TomNisbet/Simple8085/docs/_docs/images/logic-analyzers.png

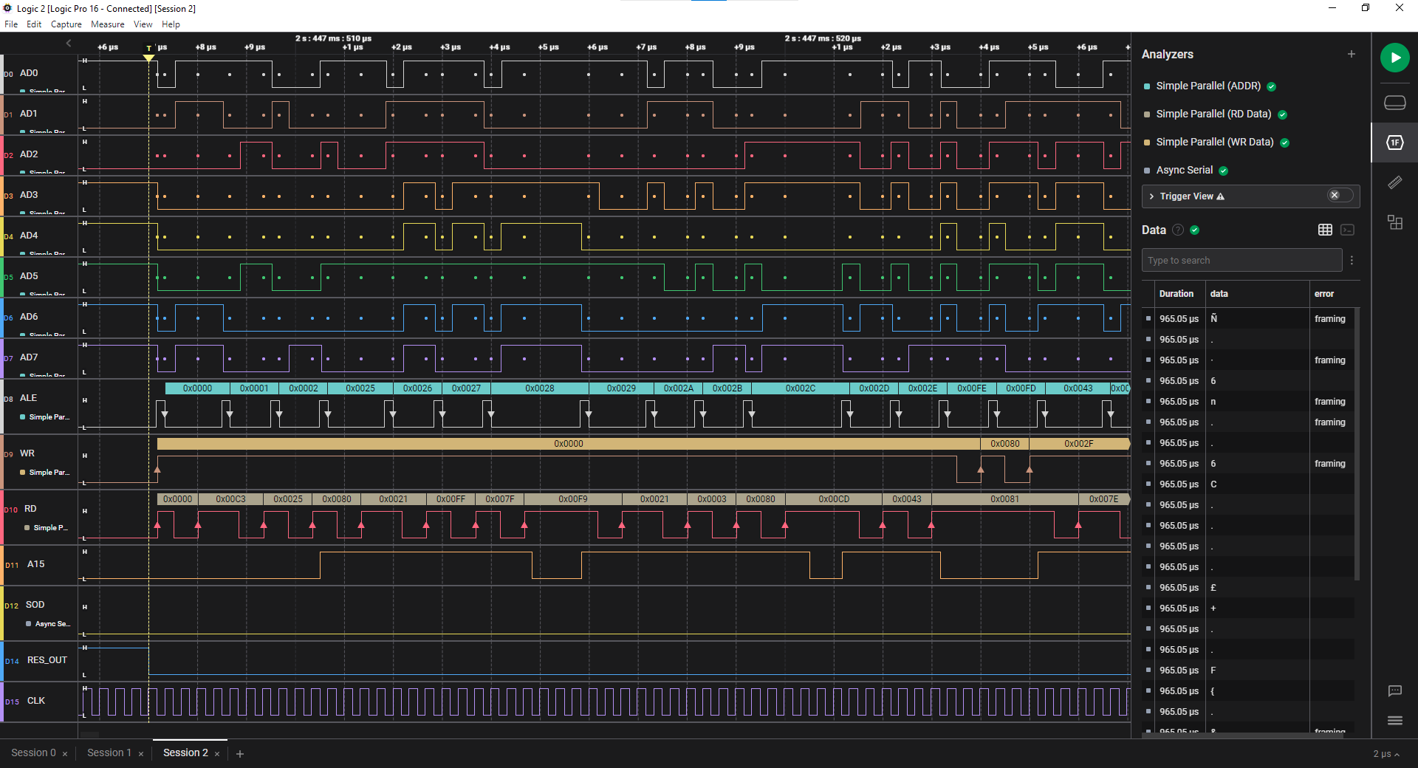
docs/_docs/images/logic-analyzers.png
