TomNisbet/Simple8085/docs/_docs/images/logic-capture.png

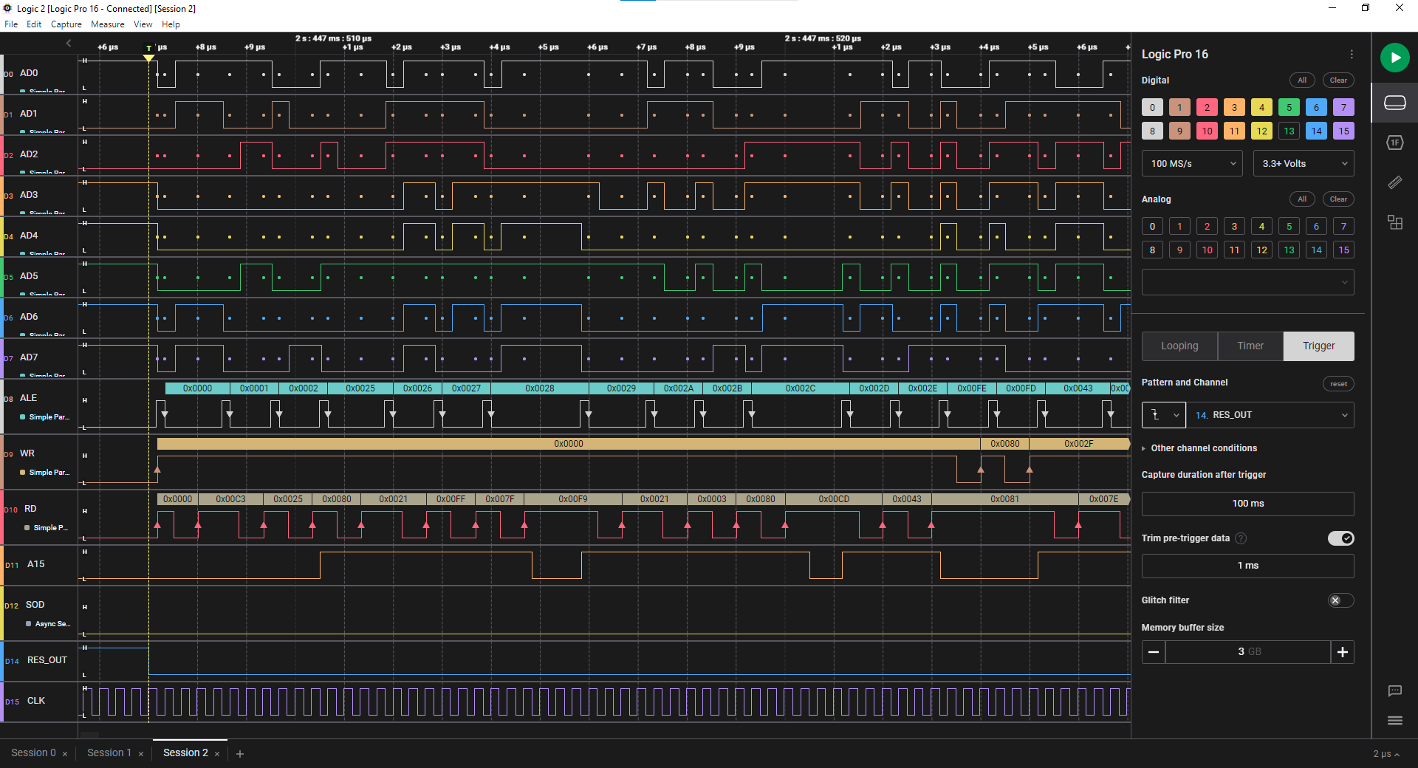
docs/_docs/images/logic-capture.png
