TomNisbet/Simple8085/docs/_docs/images/saleae-logic.jpg

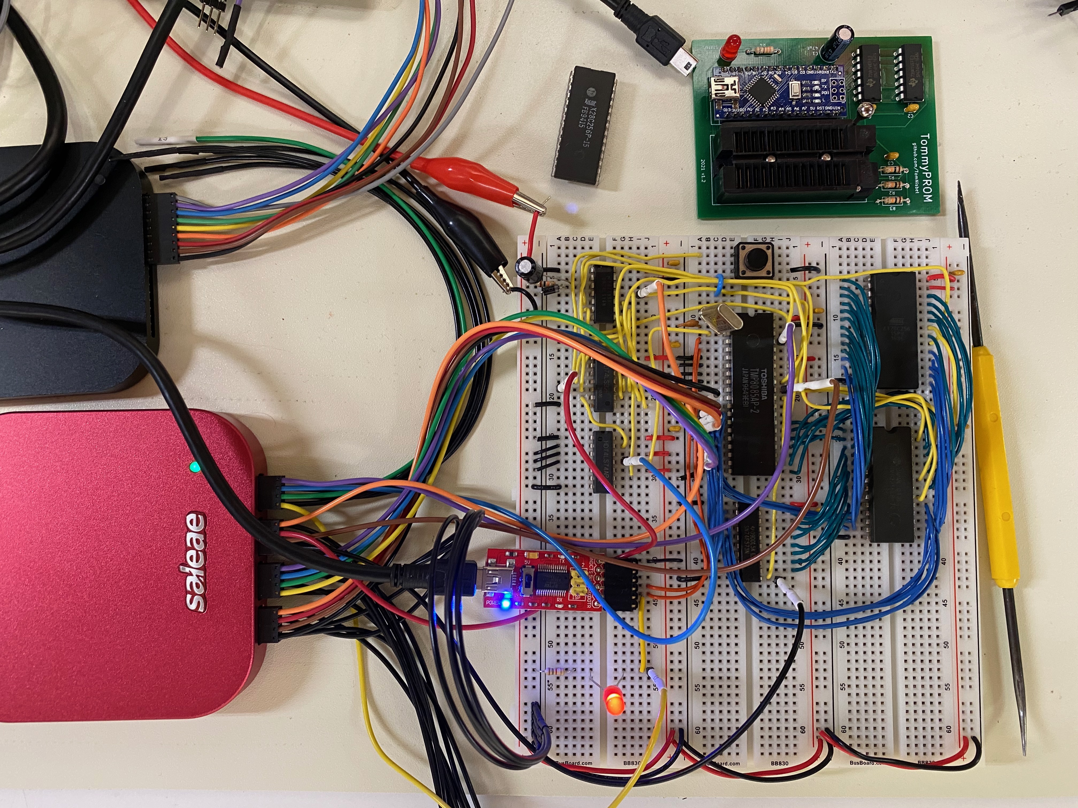
docs/_docs/images/saleae-logic.jpg
