TomNisbet/Simple8085/docs/_docs/images/simple8085-500.jpg

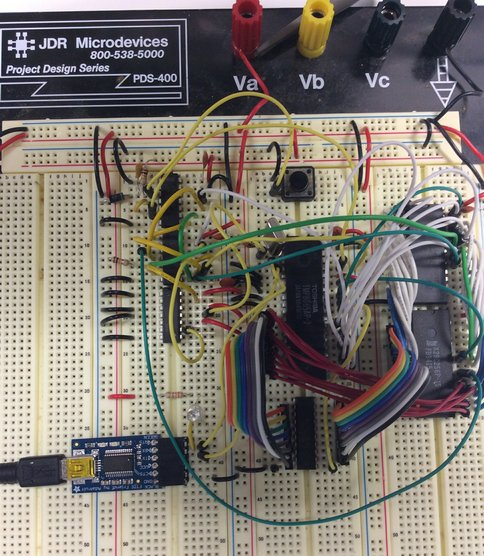
docs/_docs/images/simple8085-500.jpg
