TomNisbet/Simple8085/docs/_docs/images/simple8085-sch.png

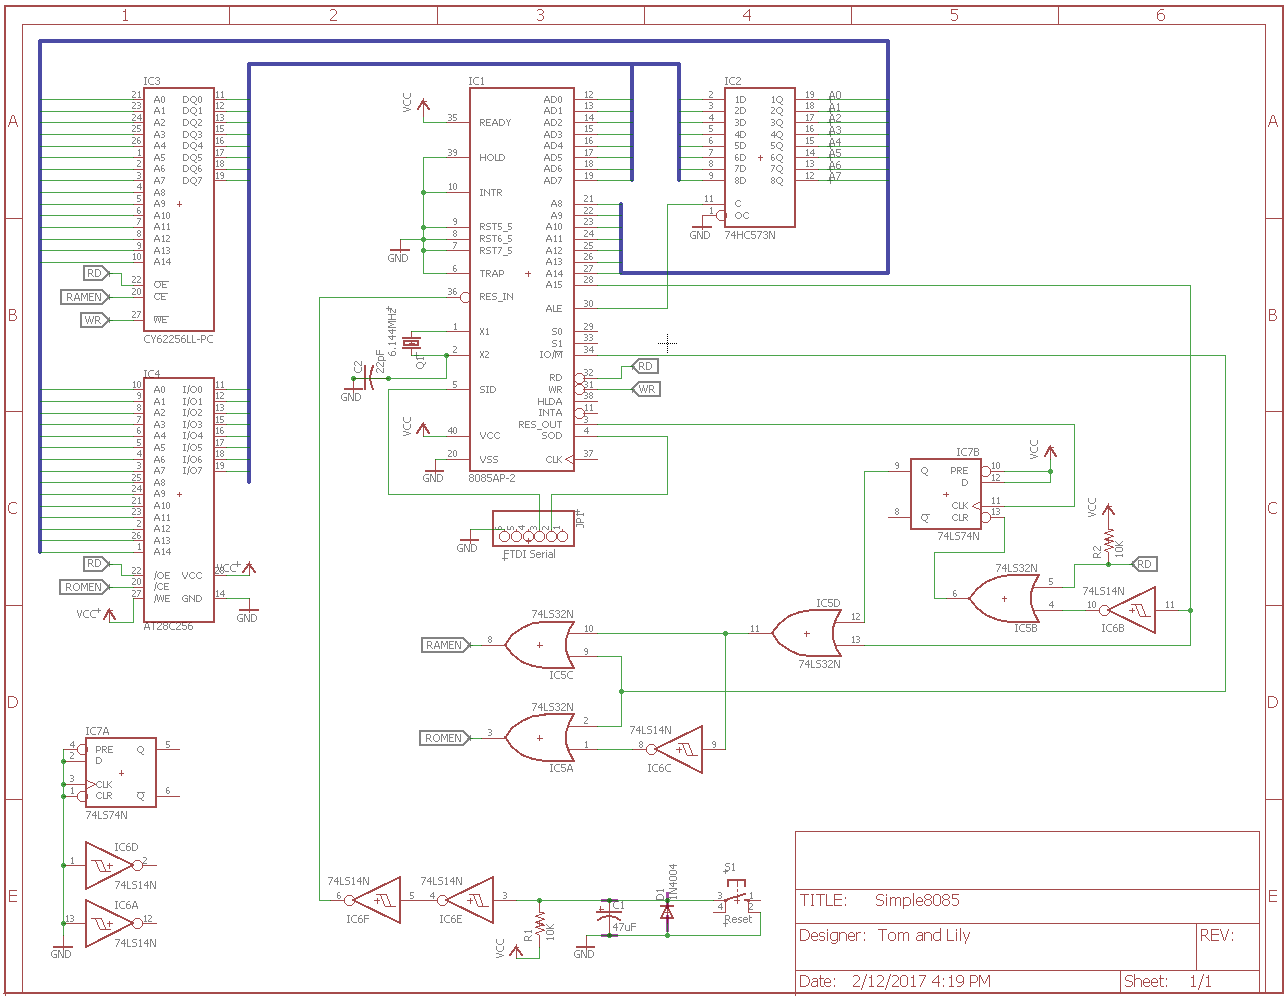
docs/_docs/images/simple8085-sch.png
