TomNisbet/Simple8085/docs/_docs/images/logic-setup.png

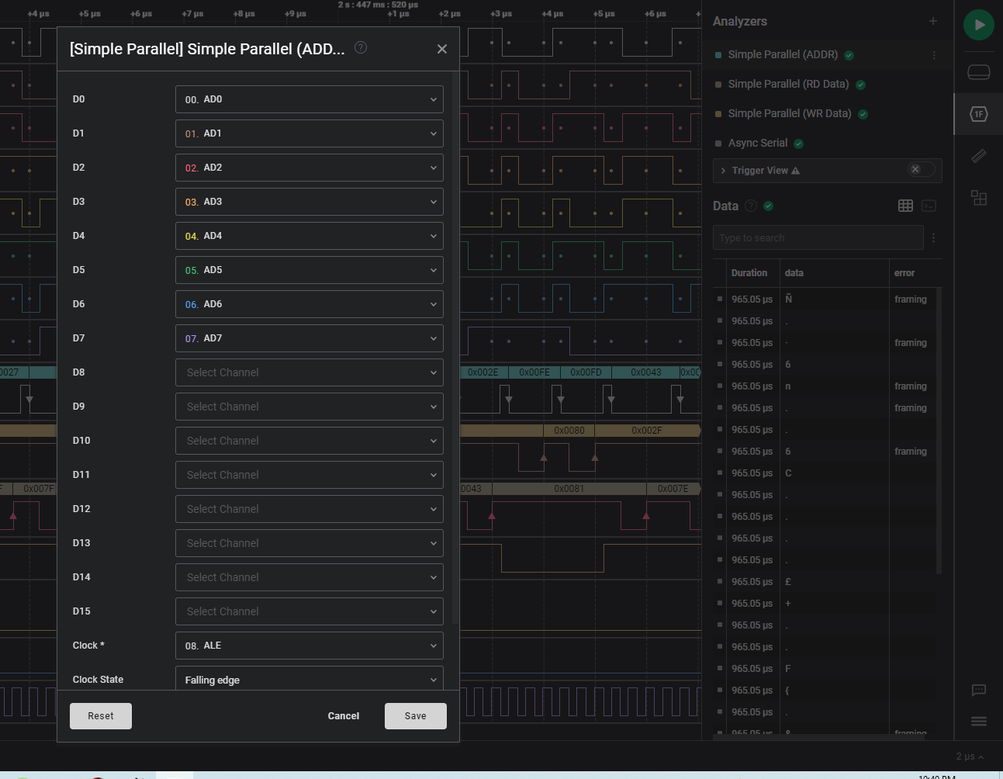
docs/_docs/images/logic-setup.png
