TomNisbet/Simple8085/docs/_docs/images/step1-free-run-sch.png

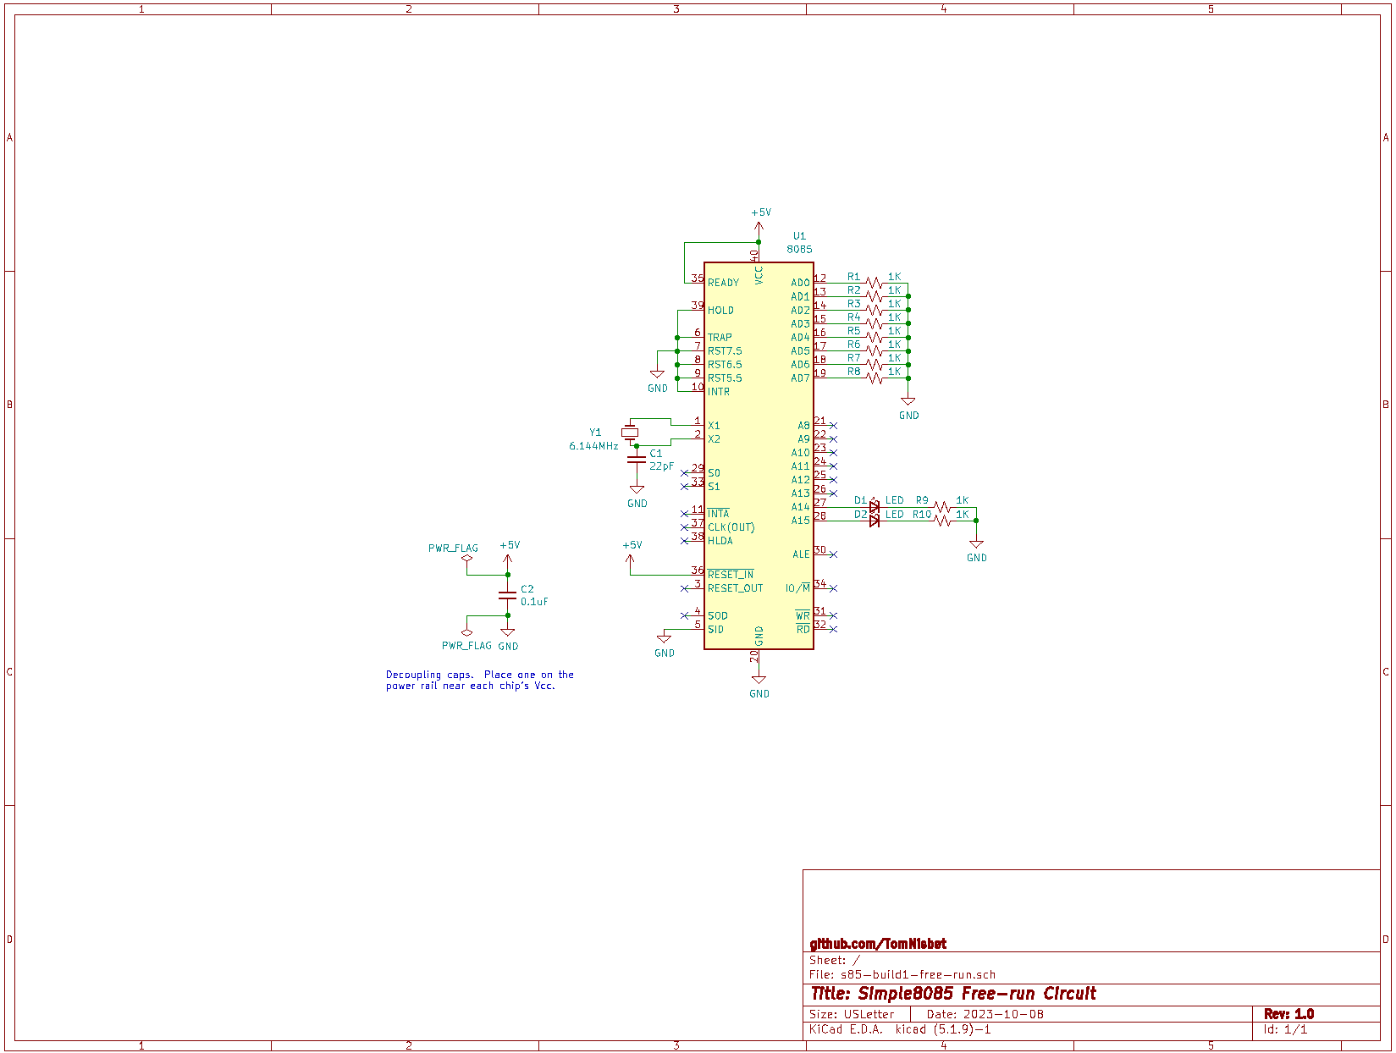
docs/_docs/images/step1-free-run-sch.png
