TomNisbet/Simple8085/docs/_docs/images/step1-free-run.jpg

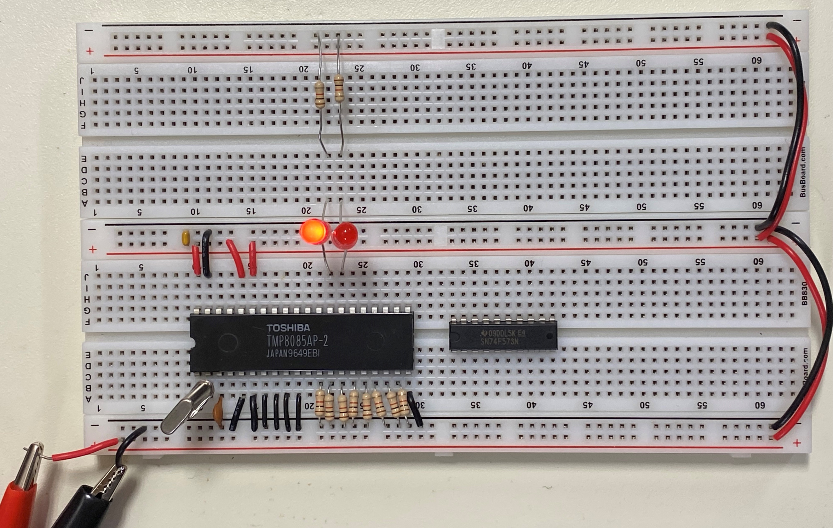
docs/_docs/images/step1-free-run.jpg
