TomNisbet/Simple8085/docs/_docs/images/step2-rom-led-sch.png

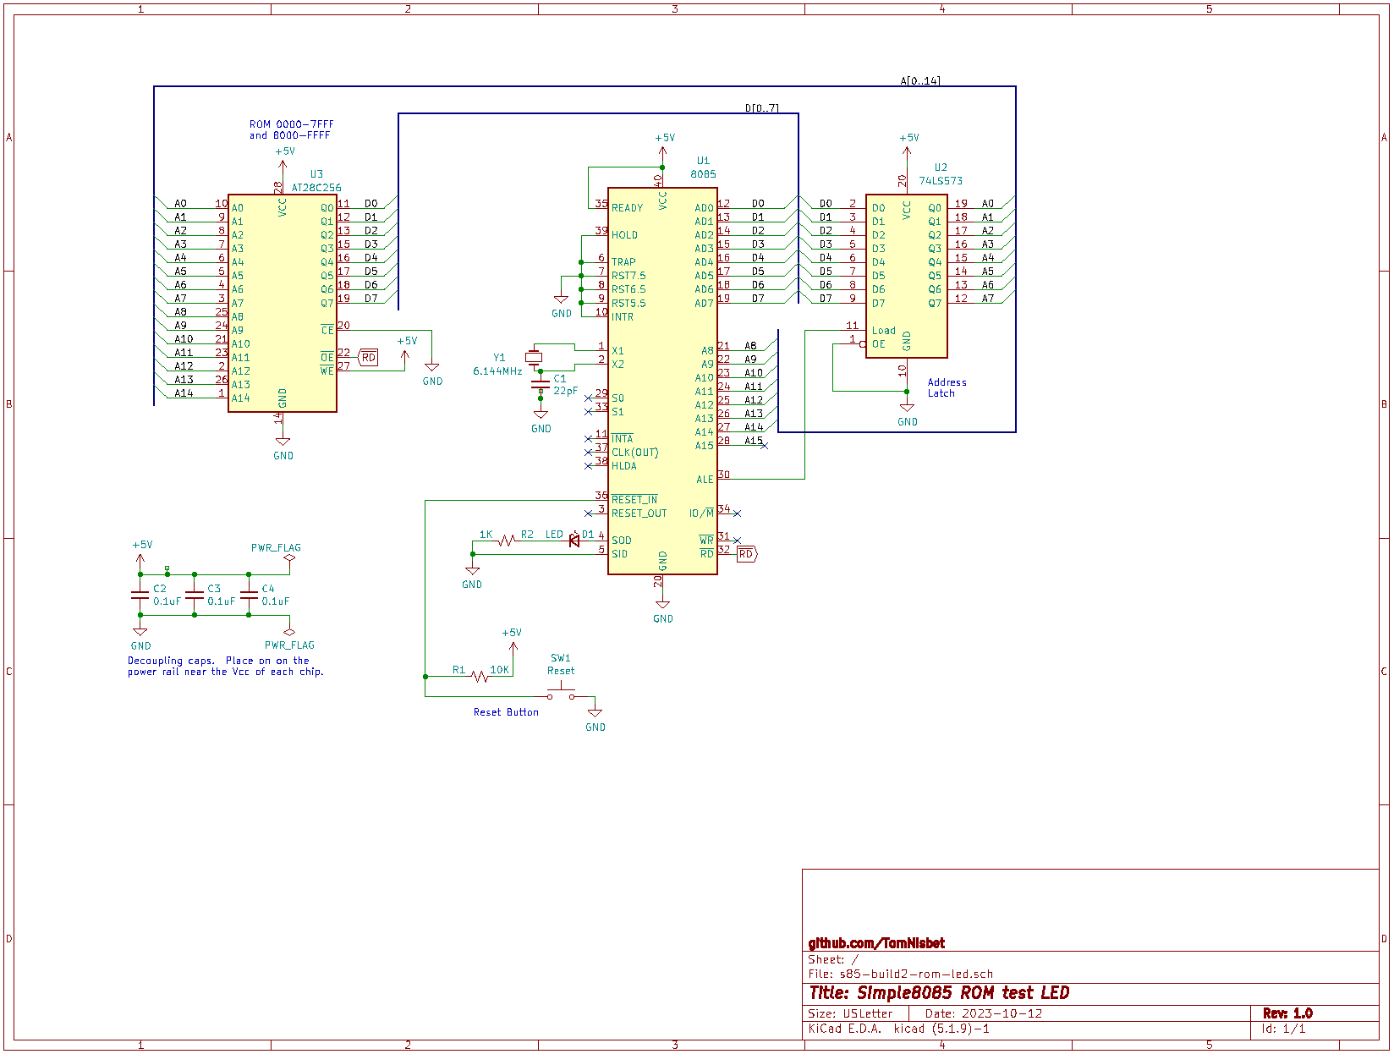
docs/_docs/images/step2-rom-led-sch.png
