TomNisbet/Simple8085/docs/_docs/images/step3-rom-serial-sch.png

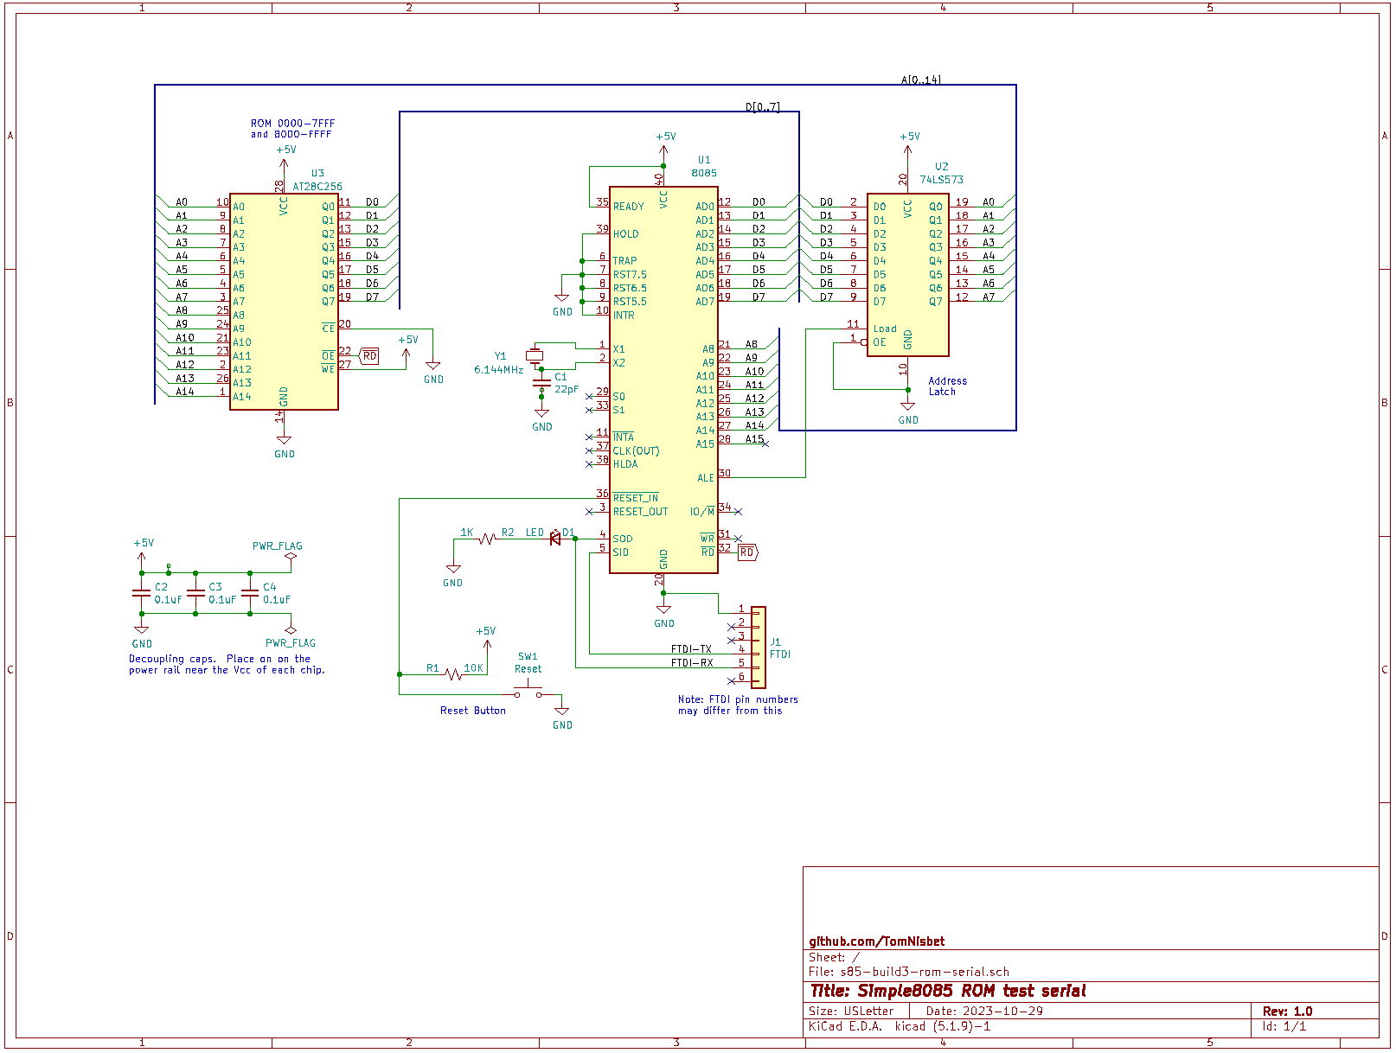
docs/_docs/images/step3-rom-serial-sch.png
