TomNisbet/Simple8085/(threads)

Thread 1 (2020-09-17):

Could you provide the ROM contents, so that other could easily replicate the design?

marcin-chwedczuk, 2020-09-17:
In short I get 2 old 8085's ICs and I just want to verify that they work. Running old MS Basic can be an excellent way to do this.

Looking at your project, I see that it's the simplest and yet fully functional 8085 based computer that I have ever seen. No part is redundant (OK we can get rid of RAM, but at the cost of Stack not working).

The only thing that is missing are ROMs that would allow someone to quickly replicate the design without spending hours looking for the original ROM and MS Basic.

I am not sure if MS Basic is still copyright'able but if you cannot add them to the repo I understand that. In that case can you contact me at 0xmarcin at gmail.com please?

TomNisbet, 2020-09-19:
I added an image of the current ROM in the hardware directory.  The ROM monitor is an extension of the original Explorer/85, with some new commands added.  Other commands that are not supported by this hardware, like single step, have been removed.  This is a bit of a work-in-progress.  The EEPROM burning code works, but it requires that a block of code if first copied out of the ROM so it can be executed from RAM.  This should be automatic, but if you just type GF800 after starting the monitor it will do the copy and then the EEPROM burn command should work.  ROM memory map is:

- 8000 - jump instruction to the monitor
- c000 - basic
- f000 - ROM monitor

TomNisbet, 2020-09-19:
To test your 8085s, you may also want to take a look at the README where it describes the build process.  You can first wire your 8085 to free-run a NOP instruction and observe the address lines,  Then add the ROM and run some simple tests.  There are some examples in the asm85 repo.  Finally, you can build the complete Simple8085 and run it code.

marcin-chwedczuk, 2020-09-21:
Thank you! I will check this out over the weekend :+1:

Closed 2021-02-22.

Thread 3 (2023-10-05):

Simple 8085

RizThomas, 2023-10-05:
Hi Tom…. Well after rebuild on a protoboard, I got it working ( somehow ).
Somehow it is very unstable… I thought if I I set my FTDI at 9600 baud, hit reset then it displays something.
It does but garbage characters until I get the right baud rate.
So maybe I should type few characters upon reset… no luck … hit and miss
Maybe I am not doing the right steps?

TomNisbet, 2023-10-05:
The monitor is expecting a space character to allow it to automatically detect the baud rate.  Set for 9600, hit reset, and then press the spacebar and it should come up.  I'll work that into the documentation somewhere.

RizThomas, 2023-10-05:
Yes!! Thanks for the reply. It was waiting for the SPACE char. I was typing H… (@9600 ) then puts out garbage char then change to 14400…. Seems stable but….
Now it WORKS.

side note: i added a resistor network on pins 6,8,9,10,39 pin 7 to SID but it did not change any behaviour of the baud rate.
THANK YOU … happy to have my 2nd 8085

9600, 2023-10-05:
Hello, you called?

RizThomas, 2023-10-05:
No .. but left a reply here….no issues now… will be creating a case for S8085
 Cheers

RizThomas, 2023-10-05:
On the 8085, pins 6, (7), 8, 9, and 39 are connected to GND.  Instead I placed 1K ohm resistors in between the pins to GND. Except for pin 7 is now connected with pin 5 SID.I saw this on Gitchworks and Altaids schematic. Without knowing the about “Spacebar” char needed as input, I thought there was s instability in the circuit…. Of course I know nothing…. I left the RN since it doesn’t affect at allSent from my iPhoneOn Oct 5, 2023, at 9:02 AM, Tom Nisbet ***@***.***> wrote:
@RizThomas - where did you add a resistor network? Not sure how or where extra resistors would impact the baud rate.

—Reply to this email directly, view it on GitHub, or unsubscribe.You are receiving this because you were mentioned.Message ID: ***@***.***>

Closed 2023-10-05.
