TomNisbet/Simple8085/(commit log)

2017-02-27 Add Eagle schematic
    [Simple8085.sch]
2023-09-25 Add warning for READY line schematic error
2023-09-29 Fix READY line connection on schematic
2023-10-06 Wiring fixes to README
2023-10-29 add photos and schematics for build steps
    [s85-build1-free-run.kicad_pcb, s85-build1-free-run.sch, s85-build2-rom-led.kicad_pcb, s85-build2-rom-led.sch]
2023-10-29 add assemble command to comments
2023-10-30 add more build step schematics and pics
    [s85-build3-rom-serial.kicad_pcb, s85-build3-rom-serial.sch, s85-build4-ram-serial.kicad_pcb, s85-build4-ram-serial.sch]
2023-11-08 update logic analyzer trace description
2023-11-12 Add shecatic for final build step
    [s85-build5-complete.kicad_pcb, s85-build5-complete.sch]
2023-11-12 update schematic image
